p-rivero/CESC16/Pictures/Clock.jpg

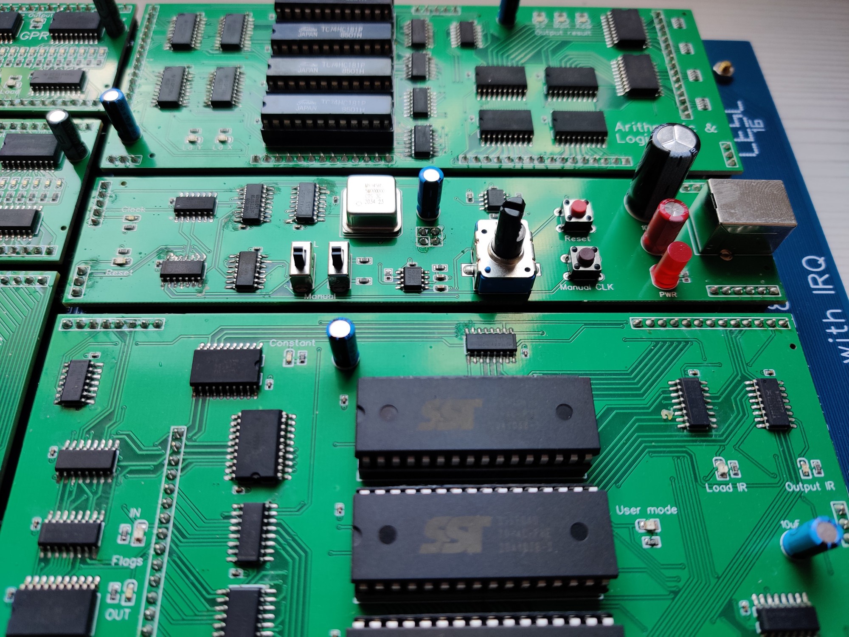
Pictures/Clock.jpg
