p-rivero/CESC16/Pictures/IO.jpg

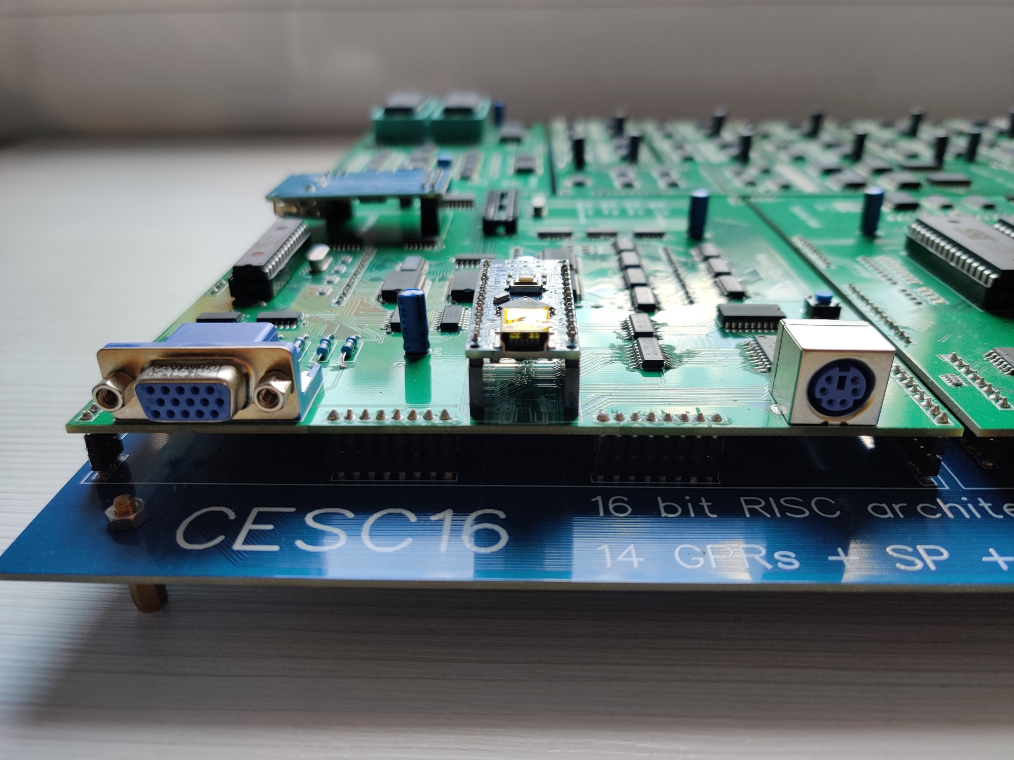
Pictures/IO.jpg
