p-rivero/CESC16/Pictures/MAR.jpg

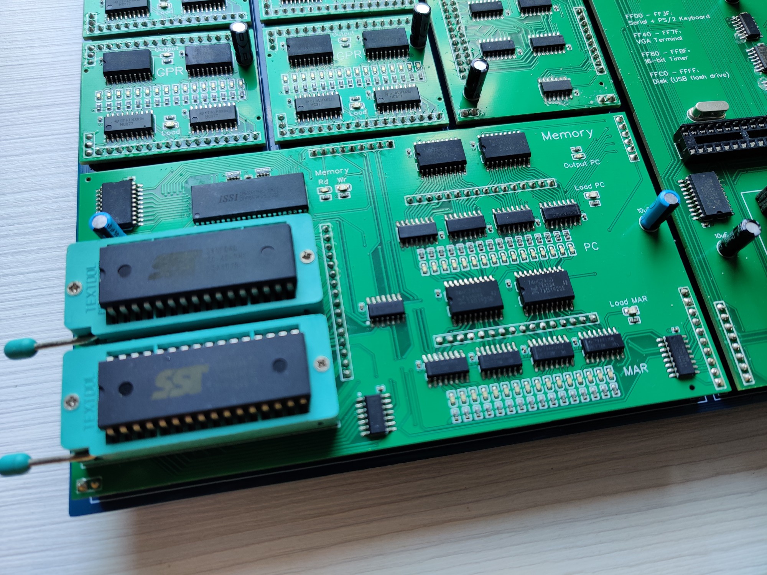
Pictures/MAR.jpg
