p-rivero/CESC16/(commit log)

2020-11-19 Added assembly preprocessor using cpp
2020-11-19 Revert "Added assembly preprocessor using cpp"
    This reverts commit b626400c7199278ae864c5c3da0b78d3300280d5.
2020-11-19 Added assembly tools
    Syntax highlighting and autocompletion for assembly code
2020-11-21 Improved routine for printing 16 bit integers
2020-12-23 Started preparing microcode for implementing interrupts
2020-12-23 Minor assembly code improvements
2020-12-24 Implemented pushf and popf instructions
    pushf stores the flags to the stack and popf restores them. This allows implementing interrupts.
2020-12-25 Implemented interrupts
    Interrupts are still a work in progress
2020-12-25 Added syscalls for attaching and detaching interrupt handlers
    Now it's much easier to add interrupt support in the user code.
    There's a new assembly example to showcase how to use them.
2020-12-28 Started implementing timer interrupts
2020-12-28 Fixed bugs in timer interrupt handler
2020-12-28 Small changes to assembly makefile
    Now it's possible to indicate which file to assemble, by using "make target=example.asm"
2020-12-29 Small changes to timer startup code
2020-12-29 Small tweaks to example assembly programs
2021-01-12 Started implementing program execution from memory
    Currently the only change is that the control lines have been shuffled. This will allow implementing instruction fetching from RAM
2021-01-12 Implemented new instructions
    - Push immediate
    - Call address in register
    - Indexed addressing for argument and destination
    - syscall and sysret for switching between ROM and RAM (not tested)
2021-01-14 Minor assembly improvements
2021-01-15 Improved assembly comments
2021-01-15 Fixed bug in interrupt calling from RAM
    Requires an update of both the microcode and the interrupt handler
2021-01-19 Improved the speed of interrupt handler
    The entire process (jump + return) is 7 cycles faster when jumping from ROM and 9 cycles faster when jumping from RAM
2021-01-27 Added tools and routines for printing strings
2021-01-27 Renamed routines for printing integers
    Char -> char
    Word -> uint16
    Signed -> int16
    DWord -> uint32
    DSigned -> int32
2021-02-12 Added tester code
    Work is progress. Eventually it should be able to test all machine instructions automatically. This will help to verify the PCB build and determine its maximum clock rate.
2021-02-20 Added code for Arduino VGA Terminal
2021-05-09 Improvements to flags testing in tester.asm
    Added an option to ignore the undefined flags (instead of forcing them to be like in the circuit simulation). A new test has been added for the overflow flag: "sub t0, zero, 0x8000"
2021-06-19 Improvements to keyboard interrupt handling
2021-06-23 Add binary output to assembler
    The FLASH programmer needs binary files instead of hex files
2021-07-02 Upload circuit schematics and PCBs
2021-07-02 Add schematics README
2021-08-15 Improve interrupt routine
2021-08-16 Improve input library
    Add constants for all special characters and begin implementing keyboard interrupts
2021-08-16 Improve example program
    Improve example_interrupts.asm so that it also prints the ASCII code of the key
2021-08-30 Improve system routines using memory-immediate instructions
    Also remove debug char when an interrupt is sent
2021-09-02 Add Fibonacci example
    Example program for printing all the 16-bit numbers in the Fibonacci sequence, using the new output control routines.
2021-09-06 Add routine for printing the HEX representation of an integer
2021-09-08 Fixes and improvements to Keyboard controller
    [Keyboard_Serial.ino]
2021-09-08 Add routine for printing an error
2021-09-08 Improve TIME library
    - Don't hardcode the end count for the timer. This allows using the end value 0xF000 as a workaround for a hardware mistake.
    - Routines for setting and reading the timer are easier to use and independent to the end value.
2021-09-08 Split OUTPUT library into 2: OUTPUT and PRINT
    OUTPUT handles the VGA terminal interface (prints characters)
    PRINT is an abstraction on top of OUTPUT in order to print different data types
2021-09-09 Improve routine for printing a decimal integer
    Add special cases for 2 and 3 digit numbers (the most common ones) so that they're printed faster.
2022-02-01 Improvements to assembler script
    This also replaces "MAIN_PROGRAM" with "main"
2022-09-04 Improve assembler compatibility and documentation
2023-03-24 [ImgBot] Optimize images
    *Total -- 6,825.64kb -> 5,718.49kb (16.22%)
    /Schematics/img/pcb/Backplane.png -- 276.21kb -> 169.28kb (38.71%)
    /Schematics/img/pcb/Memory.png -- 364.59kb -> 231.70kb (36.45%)
    /Schematics/img/pcb/Control.png -- 409.18kb -> 260.74kb (36.28%)
    /Schematics/img/pcb/IO.png -- 408.60kb -> 264.94kb (35.16%)
    /Schematics/img/pcb/GPR.png -- 191.73kb -> 125.92kb (34.32%)
    /Schematics/img/pcb/ALU.png -- 388.52kb -> 256.11kb (34.08%)
    /Schematics/img/pcb/RegfileLogic.png -- 143.33kb -> 94.53kb (34.05%)
    /Schematics/img/pcb/CLK+Reset.png -- 206.24kb -> 145.43kb (29.49%)
    /Pictures/AllModules.jpg -- 2,582.29kb -> 2,414.34kb (6.5%)
    /Pictures/Clock.jpg -- 682.20kb -> 643.37kb (5.69%)
    /Pic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
